preyneyv/mck-parting-board/out/board-B_Cu.png

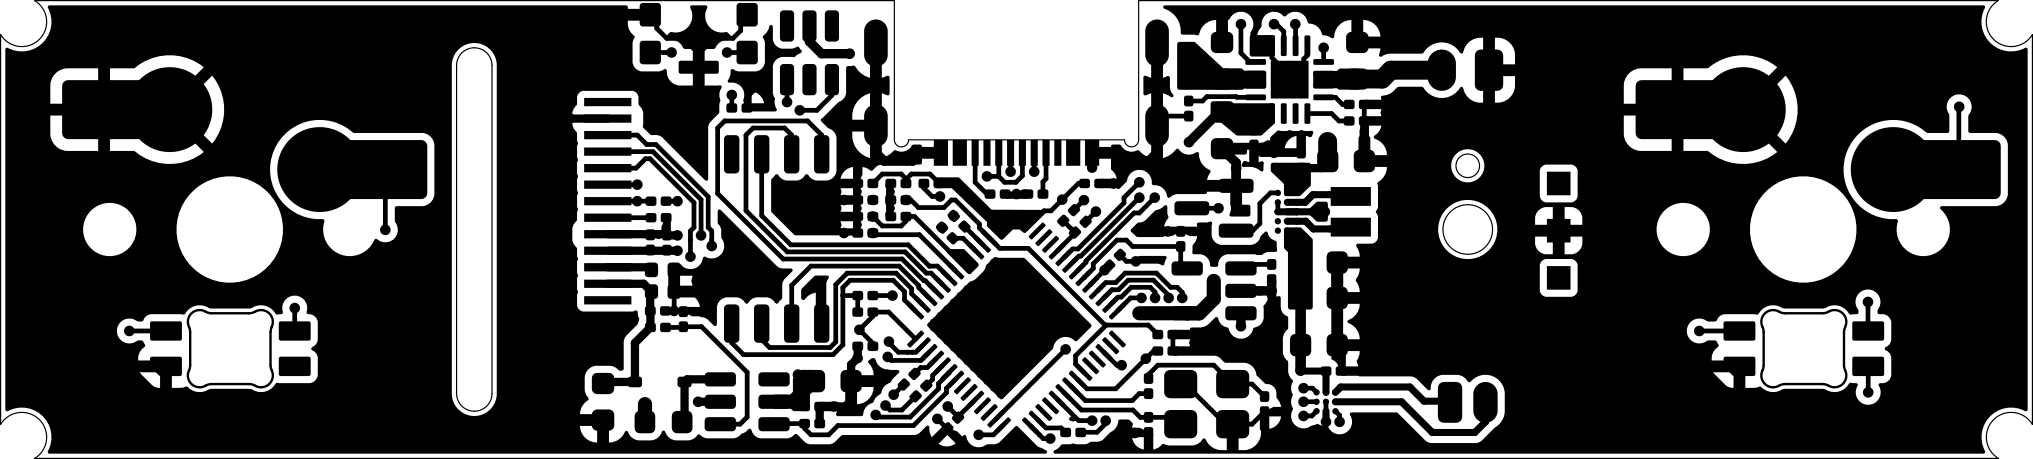
out/board-B_Cu.png
