preyneyv/mck-parting-board/out/board-B_Paste.png

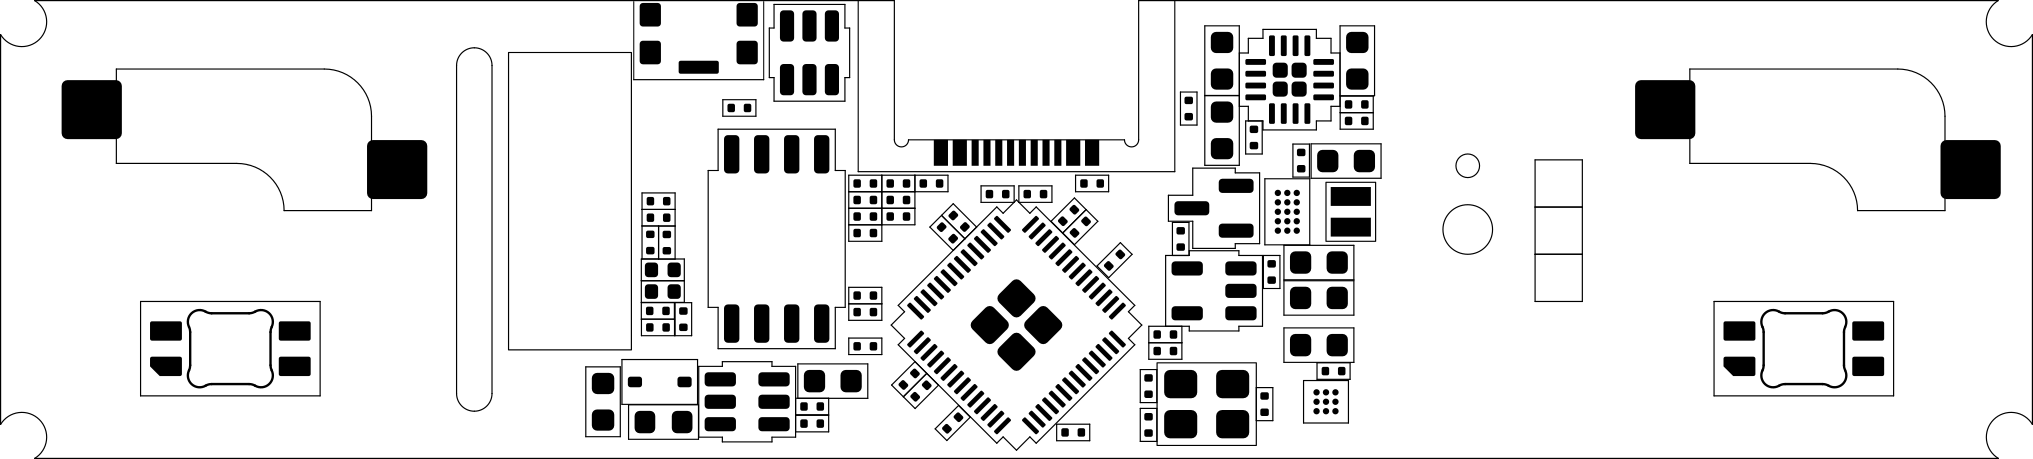
out/board-B_Paste.png
