preyneyv/mck-parting-board/out/board-F_Cu.png

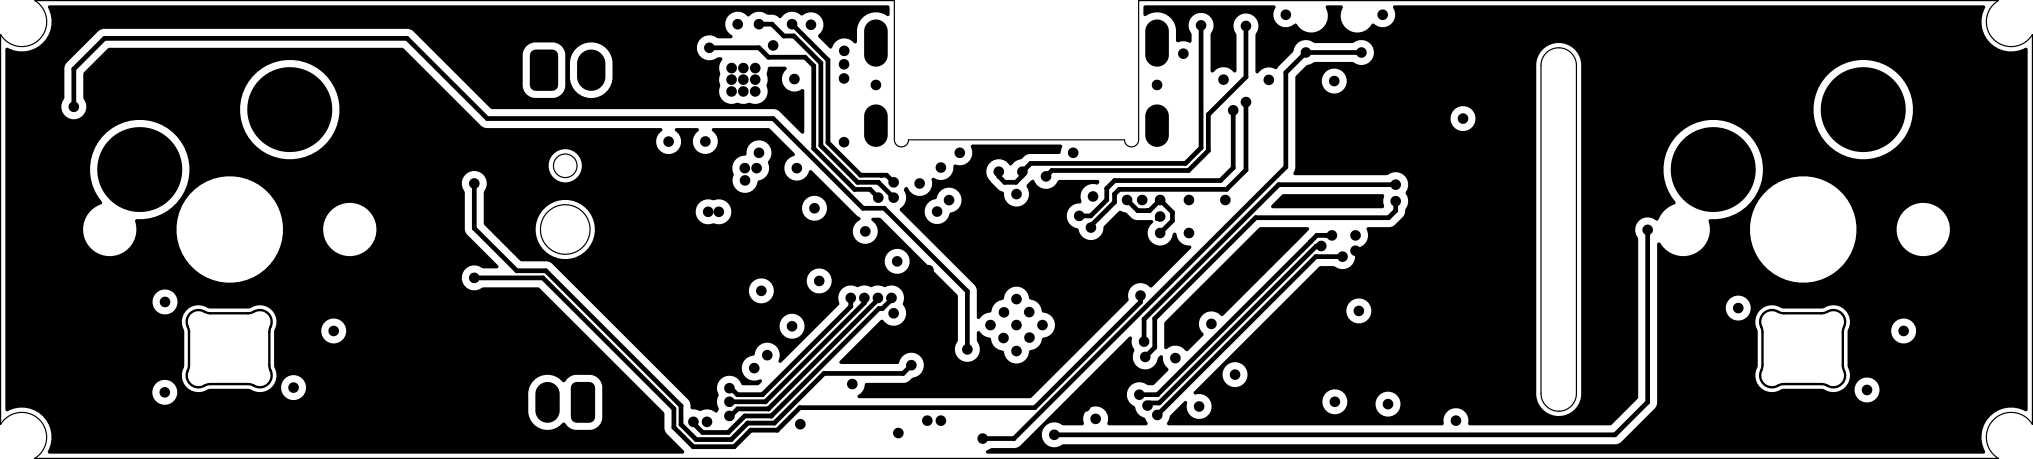
out/board-F_Cu.png
