preyneyv/mck-parting-board/out/board-F_Paste.png

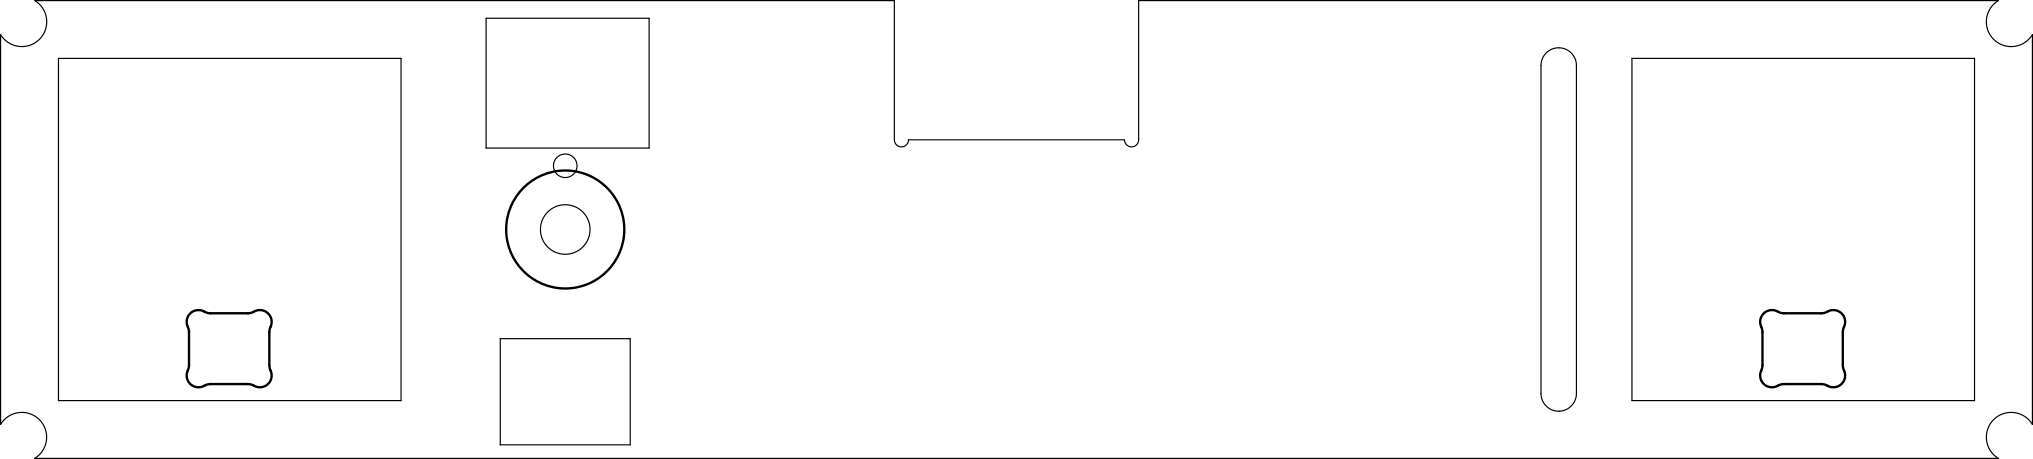
out/board-F_Paste.png
