preyneyv/mck-parting-board/out/board.png

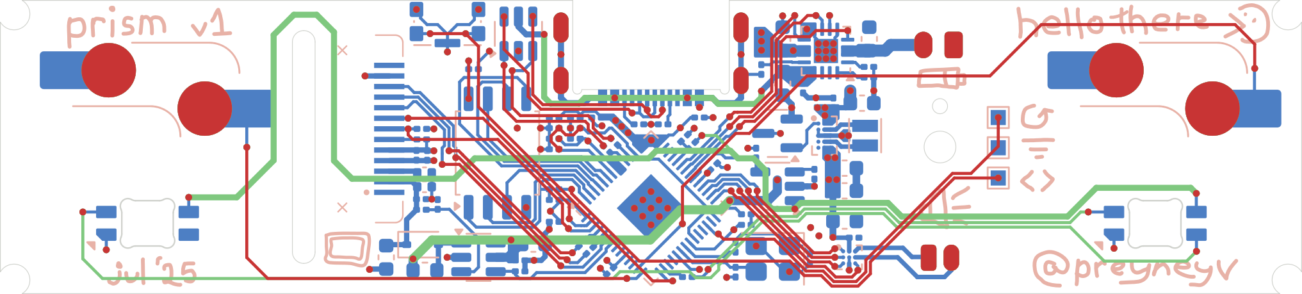
out/board.png
