preyneyv/mck-parting-board/footprints/B2B-ZR-LF--SN---3DModel-STEP-56544.STEP

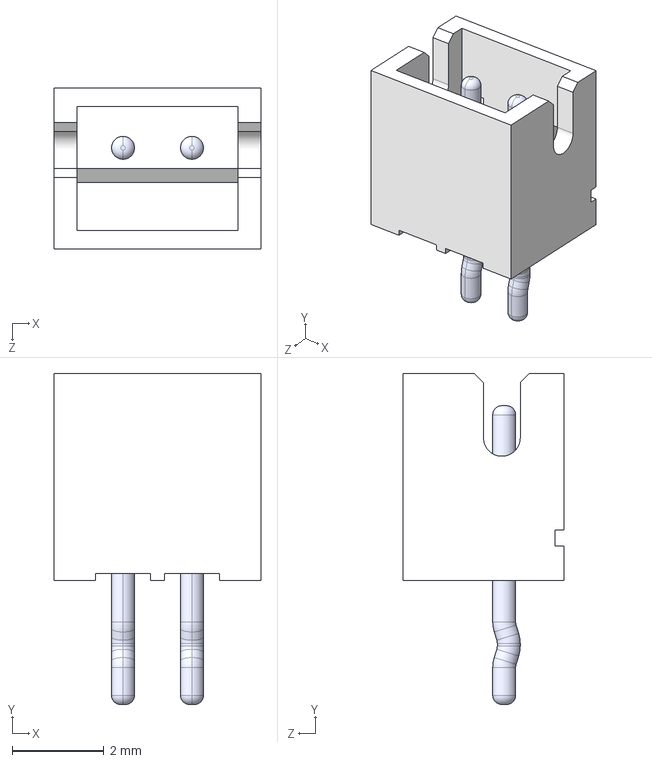
[picture p6: CAD file, 2025-07-19]
footprints/B2B-ZR-LF--SN---3DModel-STEP-56544.STEP
4.50 x 7.20 x 3.50 mm
BxB-ZR_2
pin_Bent x 2
