preyneyv/mck-parting-board/footprints/KMS221GLFS--3DModel-STEP-56544.STEP

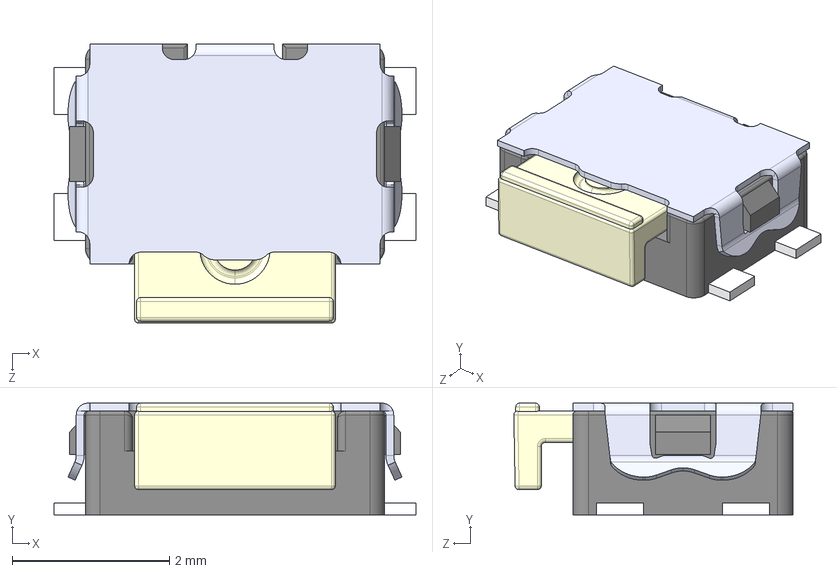
[picture p7: CAD file, 2025-07-17]
footprints/KMS221GLFS--3DModel-STEP-56544.STEP
4.60 x 1.42 x 3.55 mm
