preyneyv/mck-parting-board/footprints/SOT-523.STEP

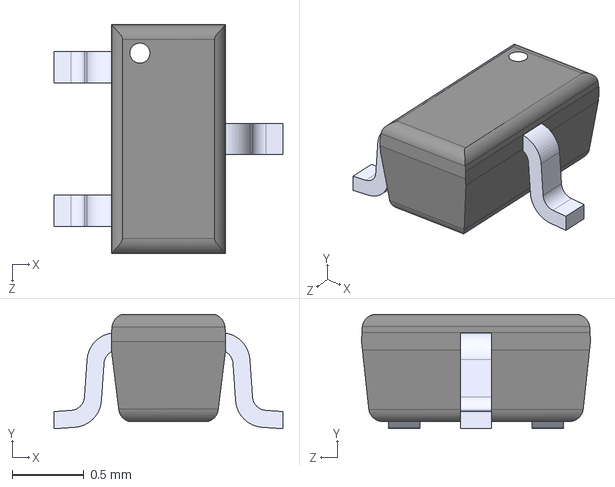
[picture p8: CAD file, 2025-07-17]
footprints/SOT-523.STEP
1.60 x 0.8 x 1.60 mm
