preyneyv/mck-parting-board/footprints/Same_Sky_UJ20-C-H-G-MSMT-6-P16-TR.step

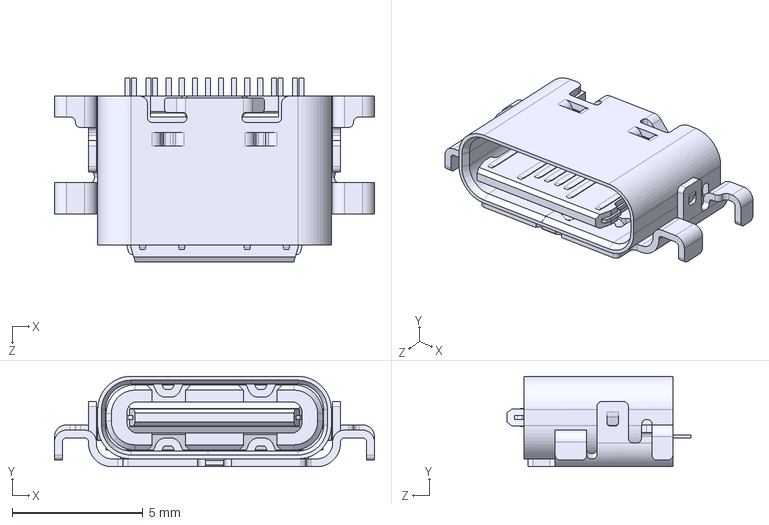
[picture p9: CAD file, 2025-07-17]
footprints/Same_Sky_UJ20-C-H-G-MSMT-6-P16-TR.step
12.2 x 3.46 x 7.05 mm
