preyneyv/mck-parting-board/footprints/RP2040.step

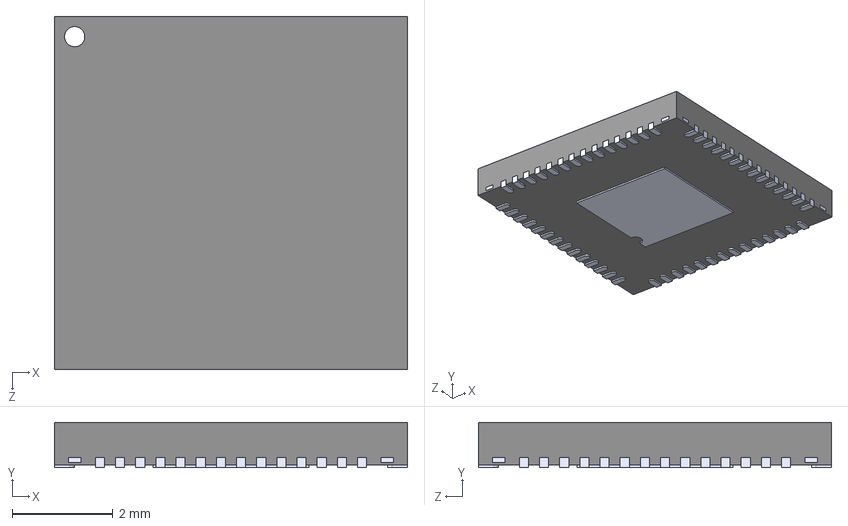
[picture p10: CAD file, 2025-07-14]
footprints/RP2040.step
7.00 x 0.9 x 7.00 mm
