preyneyv/mck-parting-board/footprints/S2B-PH-SM4-TB(LF)(SN)--3DModel-STEP-56544.STEP

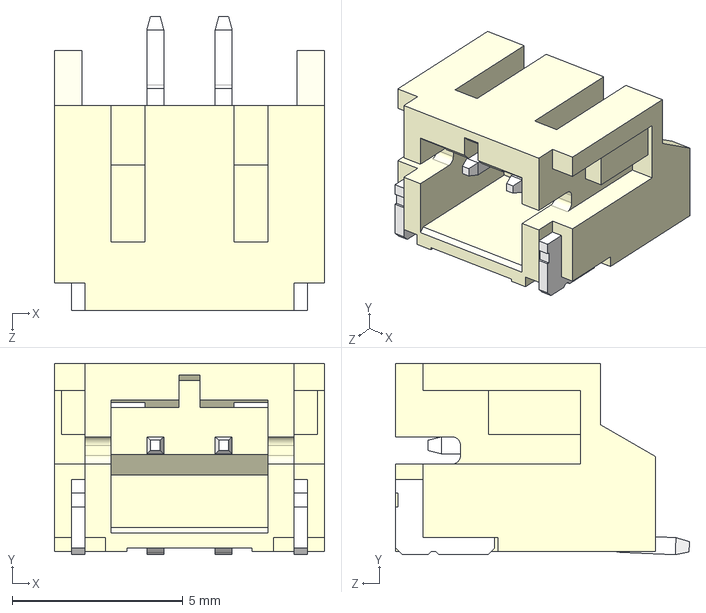
[picture p11: CAD file, 2025-07-14]
footprints/S2B-PH-SM4-TB(LF)(SN)--3DModel-STEP-56544.STEP
7.90 x 5.60 x 8.60 mm
