preyneyv/mck-parting-board/footprints/DFE201610P-1R0M=P2.STEP

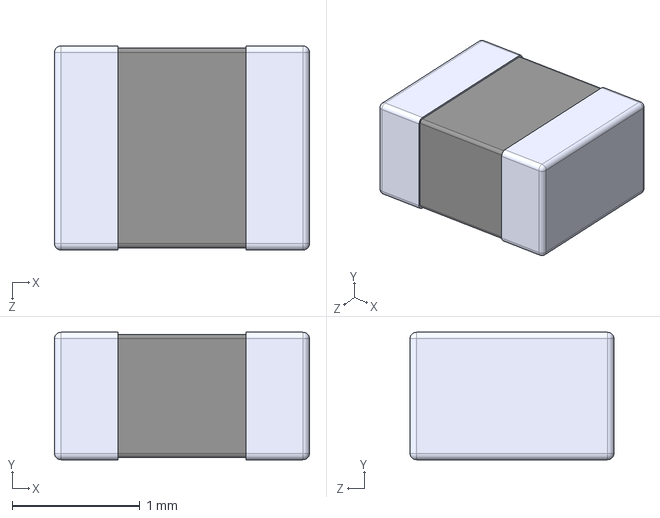
[picture p12: CAD file, 2025-07-17]
footprints/DFE201610P-1R0M=P2.STEP
2.00 x 1.00 x 1.60 mm
