preyneyv/mck-parting-board/footprints/BQ24074RGTR.step

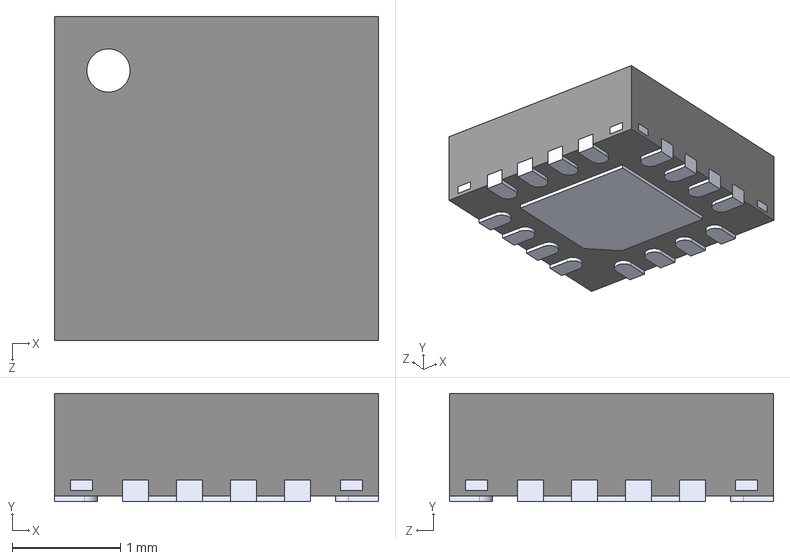
[picture p13: CAD file, 2025-07-14]
footprints/BQ24074RGTR.step
3.00 x 1.00 x 3.00 mm
