preyneyv/mck-parting-board/board.pdf

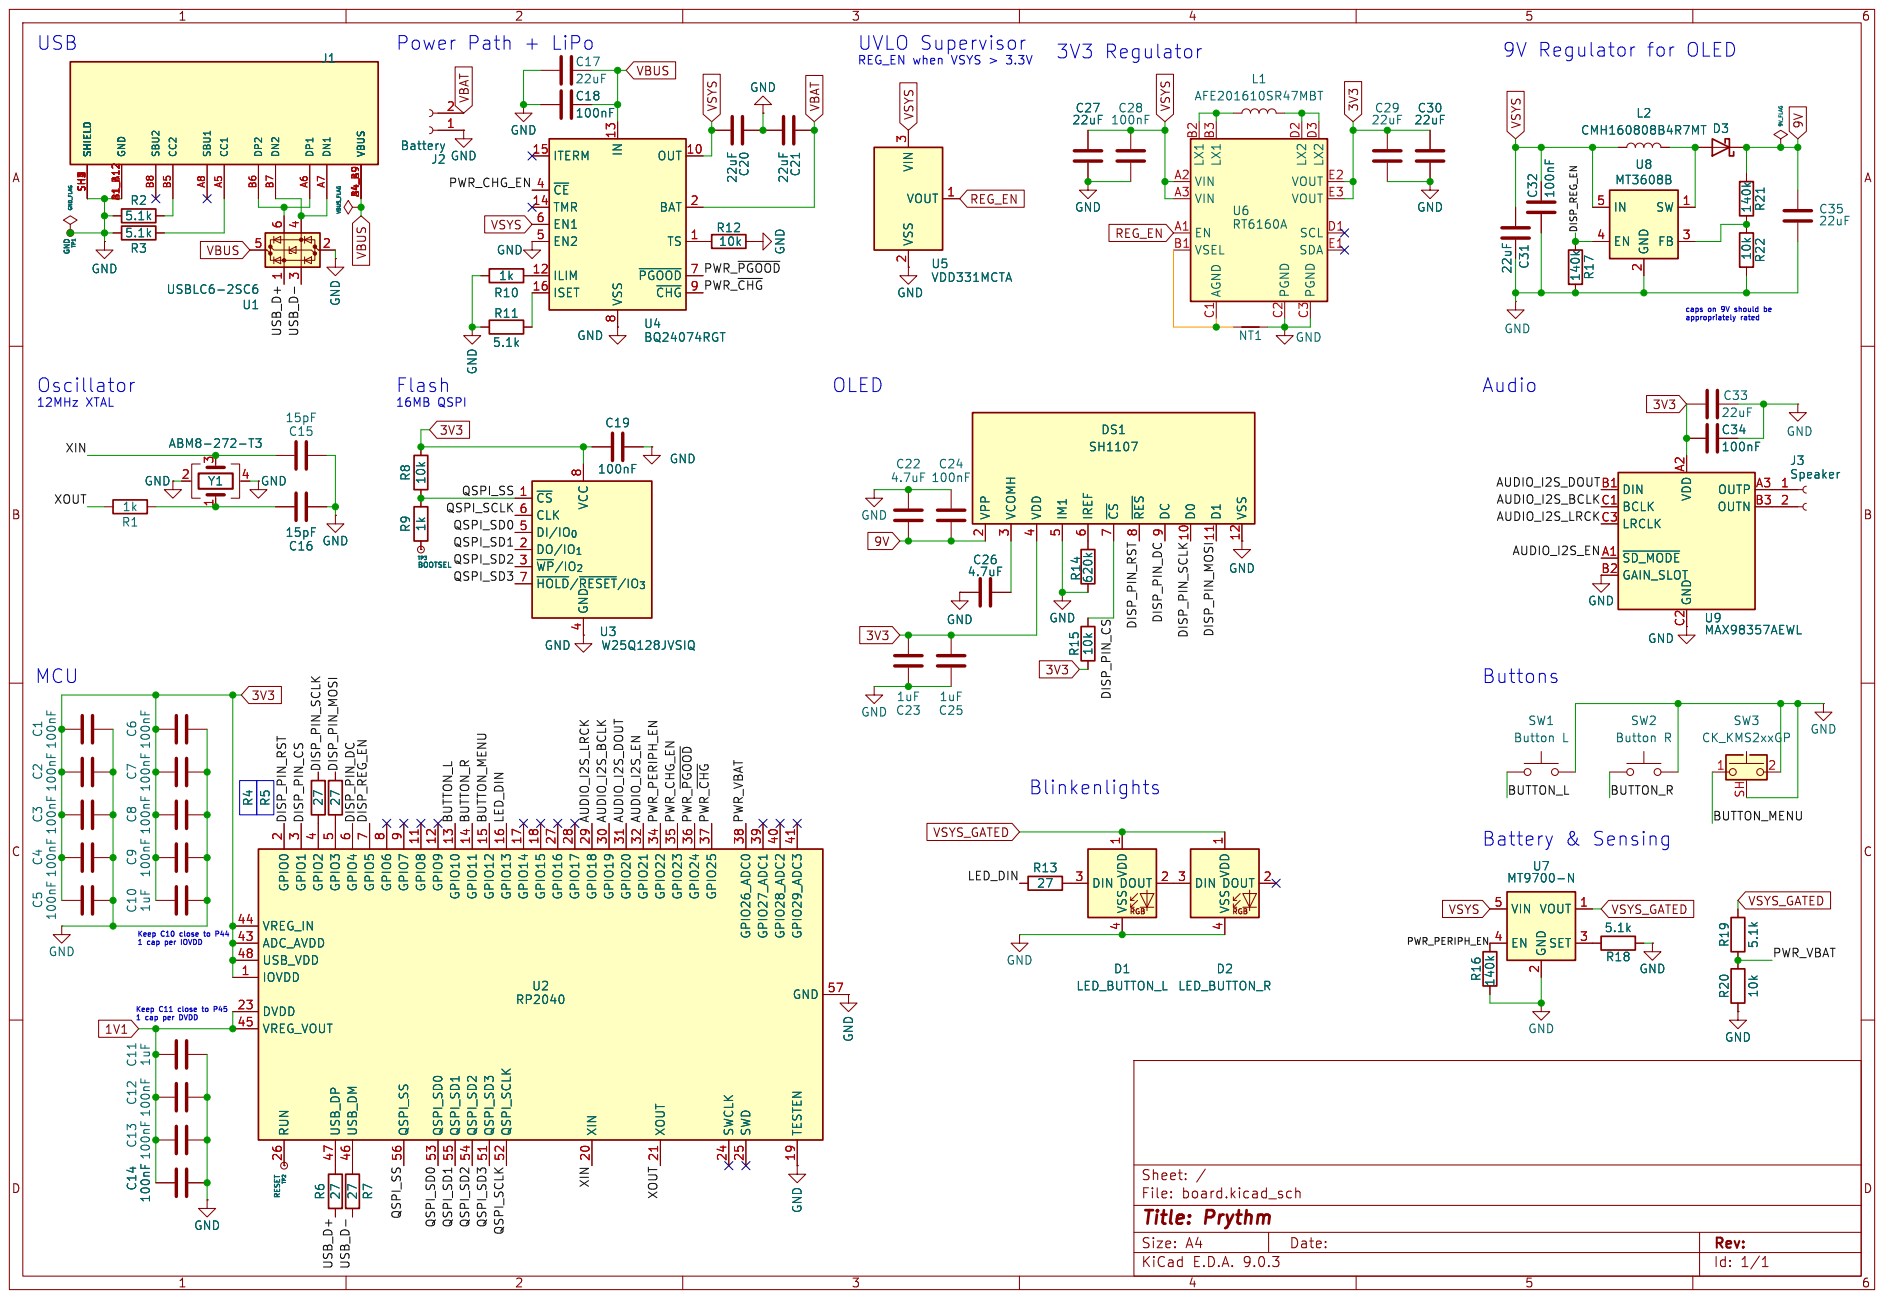
[picture p14: page 1]

BUTTON_L DISP_PIN_MOSI REG_EN when VSYS > 3.3V UVLO Supervisor

8 OUT 10 BAT 2 TS 1 ~{PGOOD}7 ~{CHG}9 U4BQ24074RGT R5 27 C9 100nF C10 1uF GND

8 OUT 10 BAT 2 TS 1 ~{PGOOD}7 ~{CHG}9 R12
