preyneyv/mck-parting-board/out/board-B_Cu.pdf

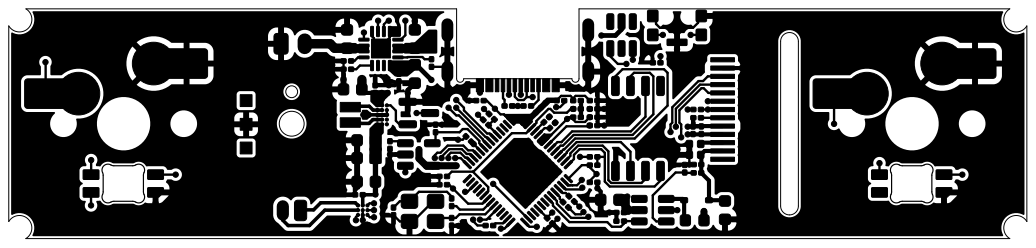
[picture p15: page 1]
