preyneyv/mck-parting-board/out/board-Edge_Cuts.pdf

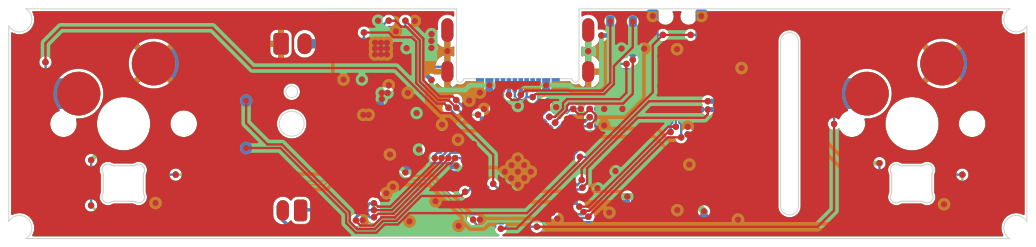
[picture p16: page 1]
