preyneyv/mck-parting-board/out/board-F_Cu.pdf

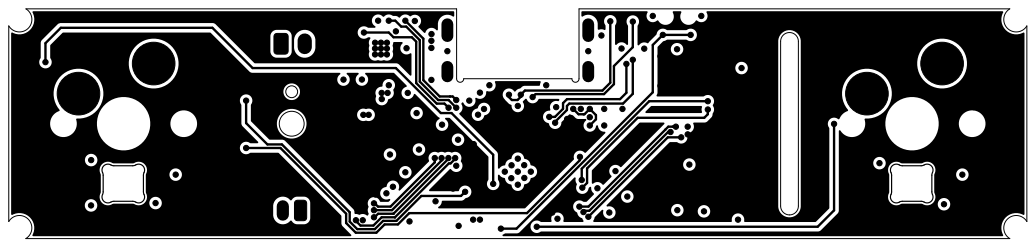
[picture p17: page 1]
