preyneyv/mck-parting-board/out/board-In1_Cu.pdf

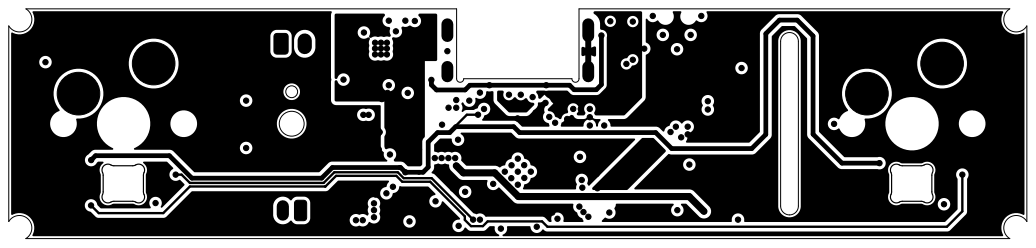
[picture p18: page 1]
