preyneyv/mck-parting-board/out/board-In2_Cu.pdf

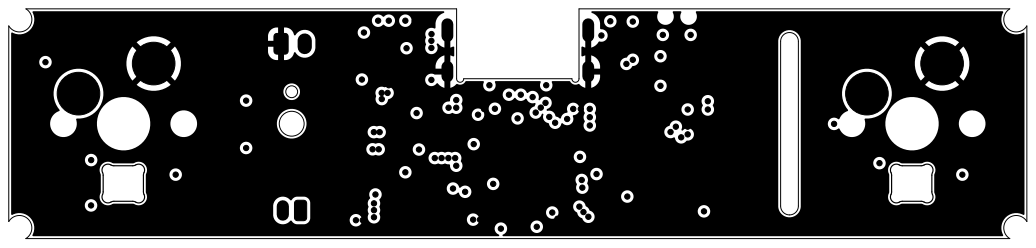
[picture p19: page 1]
