preyneyv/mck-parting-board/out/board.pdf

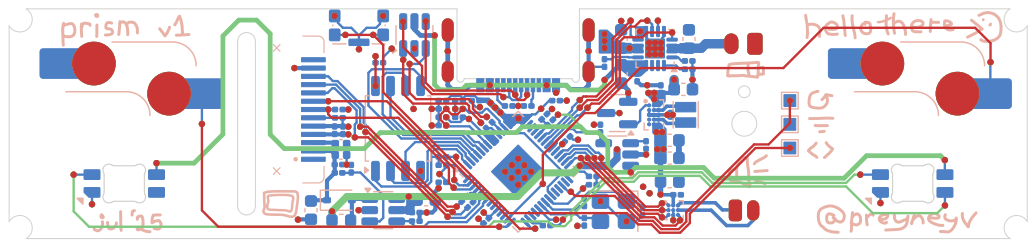
[picture p20: page 1]
