preyneyv/mck-parting-board/board.kicad_pcb

## KiCad design board.kicad_pcb (2025-07-19)

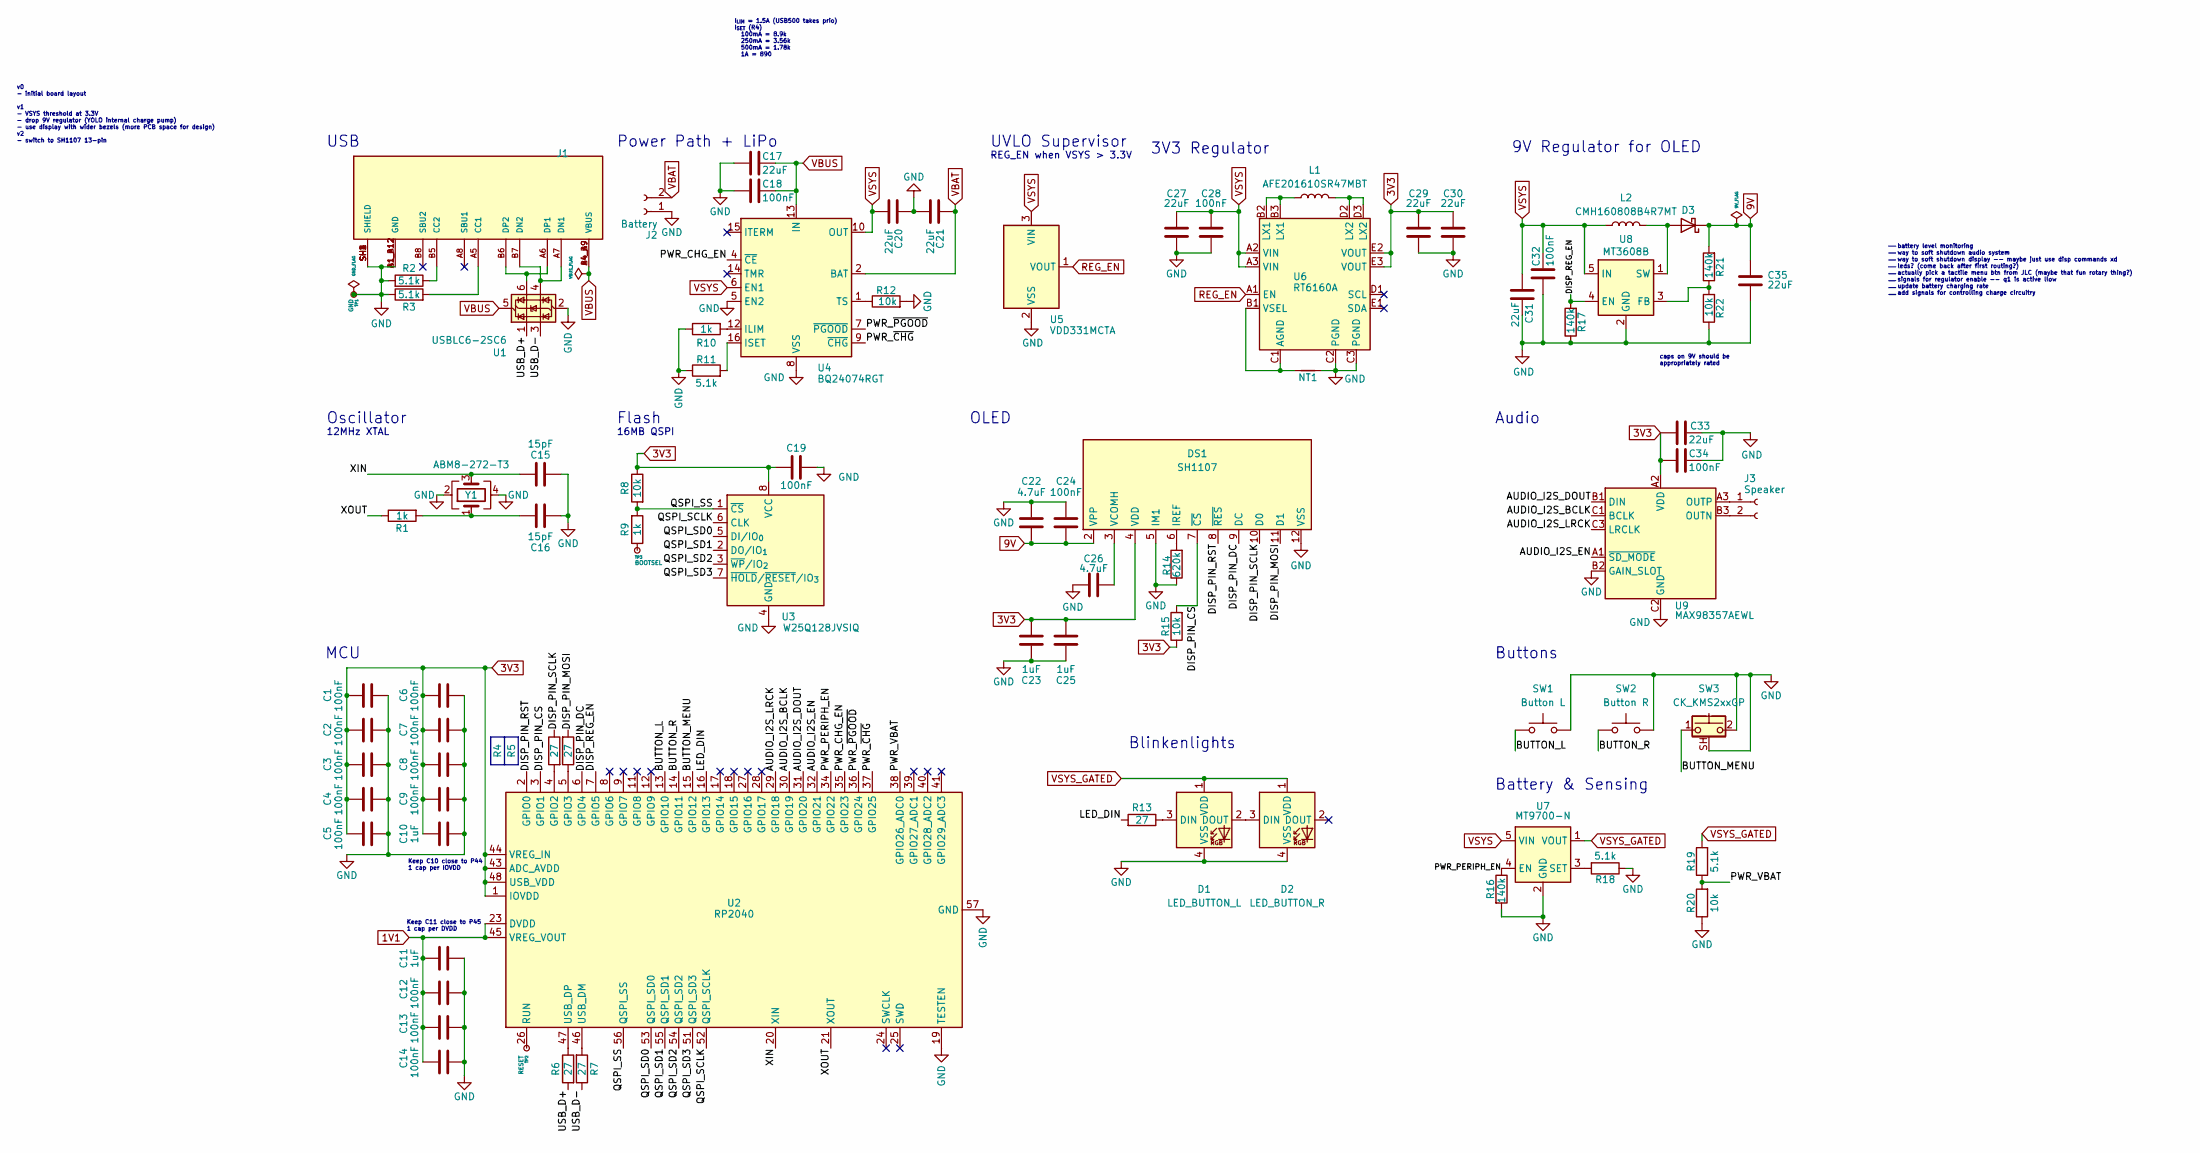
[picture p21: schematic board.kicad_sch, Prythm]

Parts:
C1, C2, C3, C4, C5, C6, C7, C8, C9, C12, C13, C14, C18, C19, C24, C28, C32, C34: 100nF; C_0201_0603Metric; LCSC C307380
C10, C11, C23, C25: 1uF; C_0201_0603Metric; LCSC C307385
C15, C16: 15pF; C_0201_0603Metric; LCSC C237567
C17, C20, C21, C27, C29, C30, C31, C33, C35: 22uF; C_0603_1608Metric; LCSC C2762594
C22, C26: 4.7uF; C_0402_1005Metric; LCSC C318563
D1: LED_BUTTON_L; LED_MX_6028R; LCSC C5242955
D2: LED_BUTTON_R; LED_MX_6028R; LCSC C5242955
D3: BAT20JFILM; D_SOD-323; LCSC C155590
DS1: SH1107; OLED_SH1107_13P
J1: UJ20-C-H-G-MSMT-6-P16-TR; SAMESKY_UJ20-C-H-G-MSMT-6-P16-TR; PARTREV 1.0; DigiKey 2223-UJ20-C-H-G-MSMT-6-P16-TRCT-ND
J2: Battery; JST_PH_B2B-PH-K_1x02_P2.00mm_Vertical; DigiKey 455-1704-ND
J3: Speaker; JST_ZH_B2B-ZR_1x02_P1.50mm_Vertical; DigiKey 455-B2B-ZR-ND
L1: AFE201610SR47MBT; L_Murata_DFE201610P; LCSC C22459313
L2: CMH160808B4R7MT; L_0603_1608Metric; LCSC C394952
NT1: NetTie_2; NetTie-2_SMD_Pad0.5mm
R1, R9, R10: 1k; R_0201_0603Metric; LCSC C138165
R2, R3, R11, R18, R19: 5.1k; R_0201_0603Metric; LCSC C274341
R4, R5, R6, R7, R13: 27; R_0201_0603Metric; LCSC C273268
R8, R12, R15, R20, R22: 10k; R_0201_0603Metric; LCSC C138117
R14: 620k; R_0201_0603Metric; LCSC C295860
R16, R17, R21: 140k; R_0201_0603Metric; LCSC C138174
SW1: Button L; SW_Hotswap_Kailh_MX_Plated
SW2: Button R; SW_Hotswap_Kailh_MX_Plated
SW3: CK_KMS2xxGP; SW_SPST_CK_KMS2xxGP; DigiKey 401-1614-1-ND
TP1: GND; TestPoint_Pad_1.0x1.0mm
TP2: RESET; TestPoint_Pad_1.0x1.0mm
TP3: BOOTSEL; TestPoint_Pad_1.0x1.0mm
U1: USBLC6-2SC6; SOT-23-6; LCSC C7519
U2: RP2040; QFN-56-1EP_7x7mm_P0.4mm_EP3.2x3.2mm; LCSC C2040
U3: W25Q128JVSIQ; SOIC-8_5.3x5.3mm_P1.27mm; LCSC C97521
U4: BQ24074RGT; VQFN-16-1EP_3x3mm_P0.5mm_EP1.6x1.6mm; LCSC C54313
U5: VDD331MCTA; SOT-23; LCSC C697886
U6: RT6160A; WL-CSP-15B_1.4x2.3_BSC; LCSC C7065276
U7: MT9700-N; SOT-23-5; LCSC C42441843
U8: MT3608B; SOT-23-6; LCSC C19189893
U9: MAX98357AEWL; WLP-9_3x3_1.437x1.347mm_W91F1+1; LCSC C2682619
Y1: ABM8-272-T3; Crystal_SMD_3225-4Pin_3.2x2.5mm; LCSC C20625731

Connections:
1V1: C11.2, C12.1, C13.1, C14.1, U2.23 (DVDD), U2.45 (VREG_VOUT), U2.50 (DVDD)
3V3: C1.1, C2.1, C3.1, C4.1, C5.1, C6.1, C7.1, C8.1, C9.1, C10.2, C19.1, C23.1, C25.1, C29.1, C30.1, C33.2, C34.1, DS1.4 (VDD), R8.1, R15.1, U2.1 (IOVDD), U2.10 (IOVDD), U2.22 (IOVDD), U2.33 (IOVDD), U2.42 (IOVDD), U2.43 (ADC_AVDD), U2.44 (VREG_IN), U2.48 (USB_VDD), U2.49 (IOVDD), U3.8 (VCC), U6.E2 (VOUT), U6.E3 (VOUT), U9.A2 (VDD)
9V: C22.1, C24.1, C35.1, D3.1 (K), DS1.2 (VPP), R21.2
/AUDIO_I2S_BCLK: U2.30 (GPIO19), U9.C1 (BCLK)
/AUDIO_I2S_DOUT: U2.31 (GPIO20), U9.B1 (DIN)
/AUDIO_I2S_EN: U2.32 (GPIO21), U9.A1 (~SD_MODE)
/AUDIO_I2S_LRCK: U2.29 (GPIO18), U9.C3 (LRCLK)
/BUTTON_L: SW1.1, U2.13 (GPIO10)
/BUTTON_MENU: SW3.1, U2.15 (GPIO12)
/BUTTON_R: SW2.1, U2.14 (GPIO11)
/DISP_PIN_CS: DS1.7 (~CS), R15.2, U2.3 (GPIO1)
/DISP_PIN_DC: DS1.9 (DC), U2.6 (GPIO4)
/DISP_PIN_MOSI: DS1.11 (D1), R5.2
/DISP_PIN_RST: DS1.8 (~RES), U2.2 (GPIO0)
/DISP_PIN_SCLK: DS1.10 (D0), R4.1
/DISP_REG_EN: R17.2, U2.7 (GPIO5), U8.4 (EN)
/LED_DIN: R13.2, U2.16 (GPIO13)
/PWR_CHG_EN: U2.35 (GPIO23), U4.4 (~CE)
/PWR_PERIPH_EN: R16.1, U2.34 (GPIO22), U7.4 (EN)
/PWR_VBAT: R19.1, R20.2, U2.38 (GPIO26_ADC0)
/PWR_~CHG: U2.37 (GPIO25), U4.9 (~CHG)
/PWR_~PGOOD: U2.36 (GPIO24), U4.7 (~PGOOD)
/QSPI_SCLK: U2.52 (QSPI_SCLK), U3.6 (CLK)
/QSPI_SD0: U2.53 (QSPI_SD0), U3.5 (DI/IO_{0})
/QSPI_SD1: U2.55 (QSPI_SD1), U3.2 (DO/IO_{1})
/QSPI_SD2: U2.54 (QSPI_SD2), U3.3 (~WP/IO_{2})
/QSPI_SD3: U2.51 (QSPI_SD3), U3.7 (~HOLD/~RESET/IO_{3})
/QSPI_SS: R8.2, R9.2, U2.56 (QSPI_SS), U3.1 (~CS)
/USB_D+: R6.2, U1.1 (I/O1)
/USB_D-: R7.1, U1.3 (I/O2)
/XIN: C15.1, U2.20 (XIN), Y1.3
/XOUT: R1.1, U2.21 (XOUT)
GND: C1.2, C2.2, C3.2, C4.2, C5.2, C6.2, C7.2, C8.2, C9.2, C10.1, C11.1, C12.2, C13.2, C14.2, C15.2, C16.1, C17.1, C18.1, C19.2, C20.1, C21.2, C22.2, C23.2, C24.2, C25.2, C26.2, C27.2, C28.2, C29.2, C30.2, C31.1, C32.1, C33.1, C34.2, C35.2, D1.4 (VSS), D2.4 (VSS), DS1.5 (IM1), DS1.12 (VSS), J1.A1_B12 (GND), J1.B1_A12 (GND), J1.SH1 (SHIELD), J1.SH2 (SHIELD), J1.SH3 (SHIELD), J1.SH4 (SHIELD), J2.1, NT1.2, R2.2, R3.1, R10.1, R11.1, R12.2, R14.1, R16.2, R17.1, R18.1, R20.1, R22.1, SW1.2, SW2.2, SW3.2, SW3.SH (B), TP1.1, U1.2 (GND), U2.19 (TESTEN), U2.57 (GND), U3.4 (GND), U4.5 (EN2), U4.8 (VSS), U4.17 (VSS), U5.2 (VSS), U6.C2 (PGND), U6.C3 (PGND), U7.2 (GND), U8.2 (GND), U9.B2 (GAIN_SLOT), U9.C2 (GND), Y1.2, Y1.4
unnamed: C16.2, R1.2, Y1.1
unnamed: D1.3 (DIN), R13.1
unnamed: D1.2 (DOUT), D2.3 (DIN)
unnamed: D3.2 (A), L2.2, U8.1 (SW)
unnamed: DS1.6 (IREF), R14.2
unnamed: C26.1, DS1.3 (VCOMH)
unnamed: J1.A5 (CC1), R3.2
unnamed: J1.B5 (CC2), R2.1
unnamed: J1.A7 (DN1), J1.B7 (DN2), U1.4 (I/O2)
unnamed: J1.A6 (DP1), J1.B6 (DP2), U1.6 (I/O1)
unnamed: J3.1, U9.A3 (OUTP)
unnamed: J3.2, U9.B3 (OUTN)
unnamed: L1.1, U6.B2 (LX1), U6.B3 (LX1)
unnamed: L1.2, U6.D2 (LX2), U6.D3 (LX2)
unnamed: R9.1, TP3.1
unnamed: R4.2, U2.4 (GPIO2)
unnamed: R5.1, U2.5 (GPIO3)
unnamed: TP2.1, U2.26 (RUN)
unnamed: R7.2, U2.46 (USB_DM)
unnamed: R6.1, U2.47 (USB_DP)
unnamed: R10.2, U4.12 (ILIM)
unnamed: R11.2, U4.16 (ISET)
unnamed: R12.1, U4.1 (TS)
unnamed: NT1.1, U6.B1 (VSEL), U6.C1 (AGND)
unnamed: R18.2, U7.3 (SET)
unnamed: R21.1, R22.2, U8.3 (FB)
REG_EN: U5.1 (VOUT), U6.A1 (EN)
VBAT: C21.1, J2.2, U4.2 (BAT), U4.3 (BAT)
VBUS: C17.2, C18.2, J1.A4_B9 (VBUS), J1.B4_A9 (VBUS), U1.5 (VBUS), U4.13 (IN)
VSYS: C20.2, C27.1, C28.1, C31.2, C32.2, L2.1, U4.6 (EN1), U4.10 (OUT), U4.11 (OUT), U5.3 (VIN), U6.A2 (VIN), U6.A3 (VIN), U7.5 (VIN), U8.5 (IN)
VSYS_GATED: D1.1 (VDD), D2.1 (VDD), R19.2, U7.1 (VOUT)

Notes on the sheet:
battery level monitoring way to soft shutdown audio system way to soft shutdown display -- maybe just use disp commands xd leds? (come back after first routing?) actually pick a tactile menu btn from JLC (maybe that fun rotary thing?) signals for regulator enable -- q1 is active llow update battery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
9V Regulator for OLED
Buttons
Oscillator
Blinkenlights
3V3 Regulator
Keep C10 close to P44 1 cap per IOVDD
12MHz XTAL
USB
16MB QSPI
I_{LIM} = 1.5A (USB500 takes prio) I_{SET} (R4) 100mA = 8.9k 250mA = 3.56k 500mA = 1.78k 1A = 890
UVLO Supervisor
Audio
Battery & Sensing
Flash
Power Path + LiPo
REG_EN when VSYS > 3.3V
MCU
OLED
Keep C11 close to P45 1 cap per DVDD
caps on 9V should be appropriately rated
v0 - initial board layout v1 - VSYS threshold at 3.3V - drop 9V regulator (YOLO internal charge pump) - use display with wider bezels (more PCB space for design) v2 - switch to SH1107 13-pin

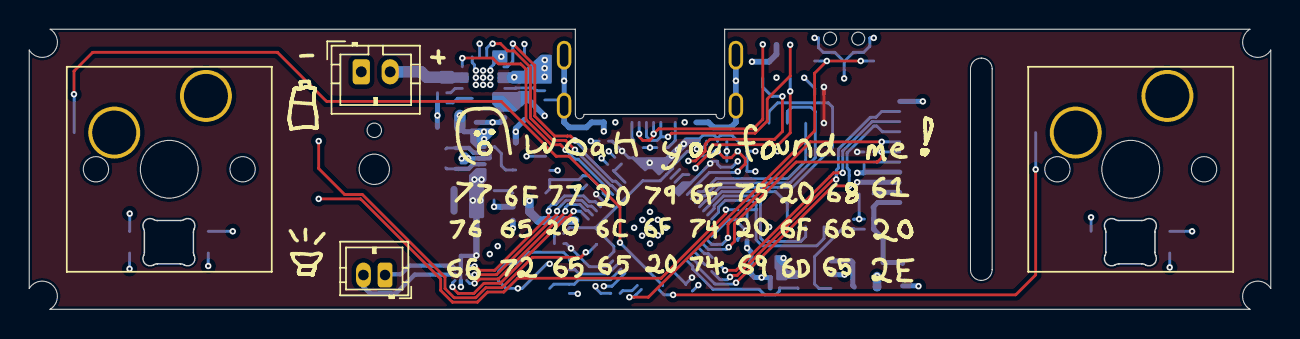
[picture p22: board board.kicad_pcb from above]

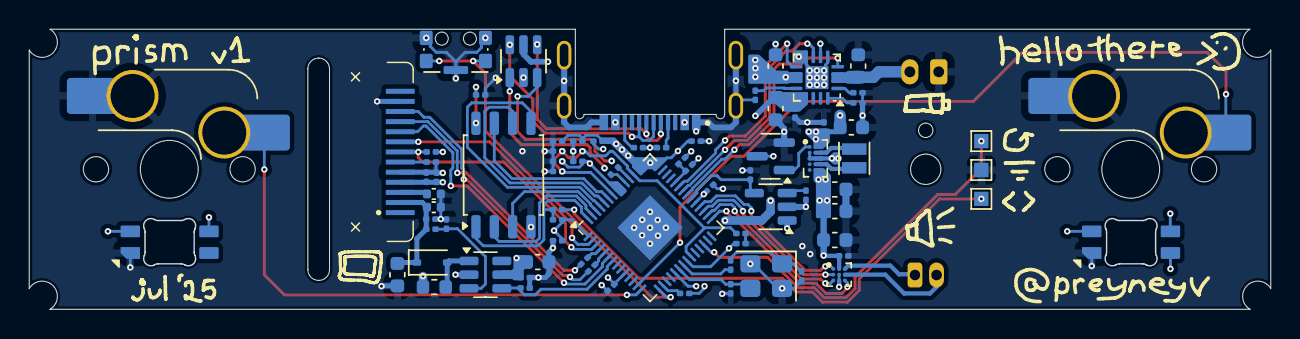
[picture p23: board board.kicad_pcb from below]

Board: 4 copper layers, 86.0 x 19.4 mm, 83 parts (79 on the bottom side), 64 nets.
