preyneyv/mck-parting-board/board_v0.kicad_pcb

## KiCad design board_v0.kicad_pcb (2025-07-14, an earlier design)

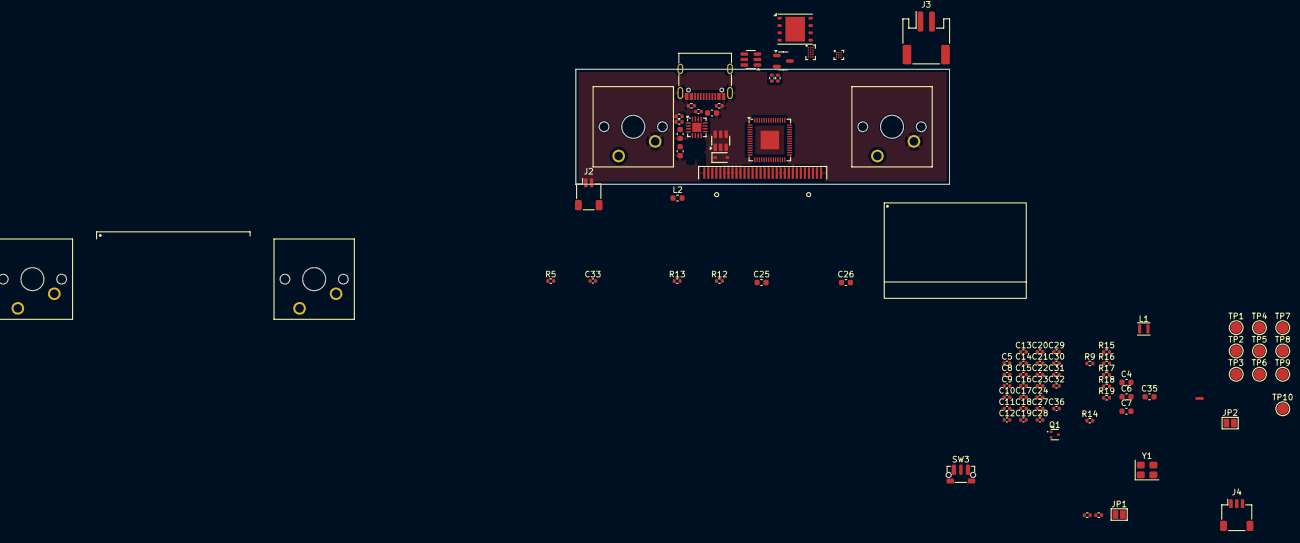
[picture p24: board board_v0.kicad_pcb from above]

Board: 4 copper layers, 65.0 x 20.0 mm, 92 parts (0 on the bottom side), 59 nets.

Parts:
C1, C3, C4, C6, C7, C25, C26, C34, C35: 22uF; C_0603_1608Metric
C2, C5, C8, C9, C10, C11, C12, C13, C14, C15, C16, C19, C20, C21, C22, C29, C31, C33, C36: 100nF; C_0402_1005Metric
C17, C18, C30, C32: 1uF; C_0402_1005Metric
C23, C24: 15pF; C_0402_1005Metric
C27, C28: 4.7uF; C_0402_1005Metric
D1: BAT20JFILM; D_SOD-323
DS1: X096-2864KSWPG01-H30; OLED-128O064D
Display: OLED 128x64 0.96"; OLED_128x64_0.96in
Display#2: OLED 128x64 0.96"; OLED_128x64_0.96in
J1: USB_C_Receptacle_USB2.0_14P; USB_C_Receptacle_G-Switch_GT-USB-7010ASV
J2: Battery; JST_SH_SM02B-SRSS-TB_1x02-1MP_P1.00mm_Horizontal
J3: Speaker; JST_PH_S2B-PH-SM4-TB_1x02-1MP_P2.00mm_Horizontal
J4: SWD; JST_SH_SM03B-SRSS-TB_1x03-1MP_P1.00mm_Horizontal
JP1: BOOTSEL; SolderJumper-2_P1.3mm_Open_Pad1.0x1.5mm
JP2: RESET; SolderJumper-2_P1.3mm_Open_Pad1.0x1.5mm
L1: 0.47uH; L_Murata_DFE201610P
L2: 4.7uH; L_0603_1608Metric
NT1: NetTie_2; NetTie-2_SMD_Pad0.5mm
Q1: DMG1012T; SOT-523
R1, R2: 5.1k; R_0402_1005Metric
R3, R7, R13, R17, R19: 10k; R_0402_1005Metric
R4, R18: 3.6k; R_0402_1005Metric
R5, R12: 140k; R_0402_1005Metric
R8, R9: 1k; R_0402_1005Metric
R10, R11, R15, R16: 27; R_0402_1005Metric
R14: 620k; R_0402_1005Metric
SW1, SW1#2: Button L; SW_Cherry_MX_1.00u_PCB
SW2, SW2#2: Button R; SW_Cherry_MX_1.00u_PCB
SW3: Menu; SW_Push_1P1T-MP_NO_Horizontal_Alps_SKRTLAE010
TP1: GND; TestPoint_Pad_D2.0mm
TP2: VBUS; TestPoint_Pad_D2.0mm
TP3: VSYS; TestPoint_Pad_D2.0mm
TP4: VBAT; TestPoint_Pad_D2.0mm
TP5: 3V3; TestPoint_Pad_D2.0mm
TP6: 9V; TestPoint_Pad_D2.0mm
TP7: REG_EN; TestPoint_Pad_D2.0mm
TP8: SNS_VBAT; TestPoint_Pad_D2.0mm
TP9: SNS_~{CHG}; TestPoint_Pad_D2.0mm
TP10: SNS_~{PGOOD}; TestPoint_Pad_D2.0mm
U1: RP2040; QFN-56-1EP_7x7mm_P0.4mm_EP3.2x3.2mm
U2: BQ24074RGT; VQFN-16-1EP_3x3mm_P0.5mm_EP1.6x1.6mm
U3: RT6160A; WL-CSP-15B_1.4x2.3_BSC
U4: TLV809EF30DBZR; SOT-23-3
U5: W25Q128JVPIQ; WSON-8-1EP_6x5mm_P1.27mm_EP3.4x4.3mm
U6: USBLC6-2SC6; SOT-23-6
U7: MT3608B; SOT-23-6
U8: MAX98357AEWL; WLP-9_3x3_1.437x1.347mm_W91F1+1
Y1: ABM8-272-T3; Crystal_SMD_3225-4Pin_3.2x2.5mm

Connections:
1V1: C18.2, C19.1, C20.1, C21.1, U1.23 (DVDD), U1.45 (VREG_VOUT), U1.50 (DVDD)
3V3: C6.1, C7.1, C8.1, C9.1, C10.1, C11.1, C12.1, C13.1, C14.1, C15.1, C16.1, C17.2, C22.1, C29.1, C30.1, C32.1, C35.2, C36.1, DS1.6 (VBAT), DS1.9 (VDD), Q1.1 (G), R7.1, R17.1, TP5.1, U1.1 (IOVDD), U1.10 (IOVDD), U1.22 (IOVDD), U1.33 (IOVDD), U1.42 (IOVDD), U1.43 (ADC_AVDD), U1.44 (VREG_IN), U1.48 (USB_VDD), U1.49 (IOVDD), U3.E2 (VOUT), U3.E3 (VOUT), U5.8 (VCC), U8.A2 (VDD)
9V: C26.1, C28.1, C31.1, D1.1 (K), DS1.28 (VCC), R12.2, TP6.1
/AUDIO_I2S_BCLK: U1.9 (GPIO7), U8.C1 (BCLK)
/AUDIO_I2S_DOUT: U1.8 (GPIO6), U8.B1 (DIN)
/AUDIO_I2S_LRCK: U1.11 (GPIO8), U8.C3 (LRCLK)
/AUDIO_I2S_SD: U1.12 (GPIO9), U8.A1 (~SD_MODE)
/BUTTON_L: SW1#2.1, U1.13 (GPIO10)
/BUTTON_MENU: SW3.1, U1.15 (GPIO12)
/BUTTON_R: SW2#2.1, U1.14 (GPIO11)
/DISP_PIN_CS: DS1.13 (~CS), R17.2, U1.3 (GPIO1)
/DISP_PIN_DC: DS1.15 (D/~C), U1.6 (GPIO4)
/DISP_PIN_MOSI: DS1.19 (D1), R16.2
/DISP_PIN_RST: DS1.14 (~RES), U1.2 (GPIO0)
/DISP_PIN_SCLK: DS1.18 (D0), R15.1
/DISP_PIN_VCC: R5.2, U1.7 (GPIO5), U7.4 (EN)
/QSPI_SCLK: U1.52 (QSPI_SCLK), U5.6 (CLK)
/QSPI_SD0: U1.53 (QSPI_SD0), U5.5 (DI/IO_{0})
/QSPI_SD1: U1.55 (QSPI_SD1), U5.2 (DO/IO_{1})
/QSPI_SD2: U1.54 (QSPI_SD2), U5.3 (~WP/IO_{2})
/QSPI_SD3: U1.51 (QSPI_SD3), U5.7 (~HOLD/~RESET/IO_{3})
/QSPI_SS: R7.2, R8.2, U1.56 (QSPI_SS), U5.1 (~CS)
/SNS_VBAT: Q1.3 (D), TP8.1, U1.38 (GPIO26_ADC0)
/SNS_~CHG: TP9.1, U1.37 (GPIO25), U2.9 (~CHG)
/SNS_~PGOOD: TP10.1, U1.36 (GPIO24), U2.7 (~PGOOD)
/USB_DM: R11.1, U6.3 (I/O2)
/USB_DP: R10.2, U6.1 (I/O1)
/XIN: C23.1, U1.20 (XIN), Y1.3
/XOUT: R9.1, U1.21 (XOUT)
GND: C1.2, C2.1, C3.1, C4.2, C5.2, C6.2, C7.2, C8.2, C9.2, C10.2, C11.2, C12.2, C13.2, C14.2, C15.2, C16.2, C17.1, C18.1, C19.2, C20.2, C21.2, C22.2, C23.2, C24.1, C25.1, C26.2, C27.2, C28.2, C29.2, C30.2, C31.2, C32.2, C33.1, C34.1, C35.1, C36.2, DS1.1 (GND), DS1.8 (VSS), DS1.10 (BS0), DS1.11 (BS1), DS1.12 (BS2), DS1.16 (R/~W), DS1.17 (E/~RD), DS1.21 (D3), DS1.22 (D4), DS1.23 (D5), DS1.24 (D6), DS1.25 (D7), DS1.29 (VLSS), DS1.30 (GND), J1.A1 (GND), J1.A12 (GND), J1.B1 (GND), J1.B12 (GND), J1.S1 (SHIELD), J2.2, J4.2, JP1.1 (A), JP2.1 (A), NT1.2, R1.1, R2.2, R3.2, R4.1, R5.1, R13.1, R14.1, R18.1, SW1#2.2, SW2#2.2, SW3.2, TP1.1, U1.19 (TESTEN), U1.57 (GND), U2.4 (~CE), U2.5 (EN2), U2.8 (VSS), U2.17 (VSS), U3.B1 (VSEL), U3.C2 (PGND), U3.C3 (PGND), U4.1 (GND), U5.4 (GND), U6.2 (GND), U7.2 (GND), U8.B2 (GAIN_SLOT), U8.C2 (GND), Y1.2, Y1.4
unnamed: C24.2, R9.2, Y1.1
unnamed: D1.2 (A), L2.2, U7.1 (SW)
unnamed: DS1.26 (IREF), R14.2
unnamed: C27.1, DS1.27 (VCOMH)
unnamed: J1.A5 (CC1), R1.2
unnamed: J1.B5 (CC2), R2.1
unnamed: J1.A6 (D+), J1.B6 (D+), U6.6 (I/O1)
unnamed: J1.A7 (D-), J1.B7 (D-), U6.4 (I/O2)
unnamed: J3.1, U8.A3 (OUTP)
unnamed: J3.2, U8.B3 (OUTN)
unnamed: J4.1, U1.24 (SWCLK)
unnamed: J4.3, U1.25 (SWD)
unnamed: JP1.2 (B), R8.1
unnamed: JP2.2 (B), U1.26 (RUN)
unnamed: L1.1, U3.B2 (LX1), U3.B3 (LX1)
unnamed: L1.2, U3.D2 (LX2), U3.D3 (LX2)
unnamed: Q1.2 (S), R18.2, R19.1
unnamed: R15.2, U1.4 (GPIO2)
unnamed: R16.1, U1.5 (GPIO3)
unnamed: R11.2, U1.46 (USB_DM)
unnamed: R10.1, U1.47 (USB_DP)
unnamed: R4.2, U2.16 (ISET)
unnamed: R3.1, U2.1 (TS)
unnamed: NT1.1, U3.C1 (AGND), U3.D1 (SCL), U3.E1 (SDA)
unnamed: R12.1, R13.2, U7.3 (FB)
REG_EN: TP7.1, U3.A1 (EN), U4.2 (~RESET)
VBAT: C1.1, J2.1, R19.2, TP4.1, U2.2 (BAT), U2.3 (BAT)
VBUS: C2.2, C34.2, J1.A4 (VBUS), J1.A9 (VBUS), J1.B4 (VBUS), J1.B9 (VBUS), TP2.1, U2.13 (IN), U6.5 (VBUS)
VSYS: C3.2, C4.1, C5.1, C25.2, C33.2, L2.1, TP3.1, U2.6 (EN1), U2.10 (OUT), U2.11 (OUT), U3.A2 (VIN), U3.A3 (VIN), U4.3 (VCC), U7.5 (IN)
