preyneyv/mck-parting-board/(commit log)

2025-07-18 routing complete??
    [board.kicad_pcb]
2025-07-19 done (?)
    [B2B-ZR-LF--SN---3DModel-STEP-56544.STEP, board.kicad_pcb]
